KeenanMcConkey/CALVIN/README.md

# CALVIN's Website

Repository for CALVIN Engineering Physics robot project (2017).

#### Link to Website
https://keenanmcconkey.github.io/CALVIN/

*Project by Keenan McConkey, Austin Khorram, and Glyn Finck*
