KeenanMcConkey/CALVIN/index.md

Welcome to CALVIN's Website
======

### Introduction to CALVIN

CALVIN was created by Keenan McConkey, Austin Khorram, and Glyn Finck for the University of British Columbia's Engineering Physics program's annual robot competition. This year's competition involved various tasks for the robot to complete, such as line following,  infrared beacon reading, and finally picking up toys ("agents" as we called them) off platforms then putting these toys into a box, which gets to be sent down a zip-line back to the beginning of the course. CALVIN has numerous features he uses as he attempts to complete this difficult challenge and rescue the agents!

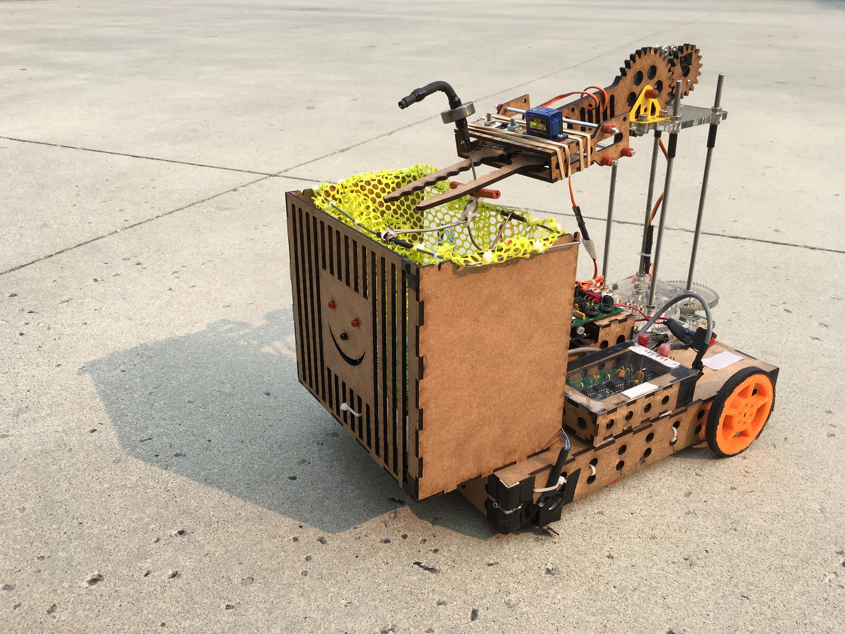
[picture p4: images/calvin_concrete.jpg]
Concrete


### CALVIN's Main Features

* Wooden Chassis
* Black Tape Detectors   
* Infrared Beacon Detectors
* Incline Detection Switches
* Modular H-Bridges and IR Signal Filters
* Servo Motor and Gear Actuated Crane, Arm, and Grabbing Claw
* TINAH Board (Arduino Board Variant)

### Navigating This Site

Check out the pages below to learn more about CALVIN's different features.

* [Mechanical](mechanical.md)
* [Electrical](electrical.md)
* [Software](software.md)

### Support or Contact

Regarding questions or inquiriues you can reach the team members at our team email address.

[CALVINteam@gmail.com](CALVINteam@gmail.com)
