KeenanMcConkey/CALVIN/electrical.md

[Return to Homepage](index.md)
# Electrical
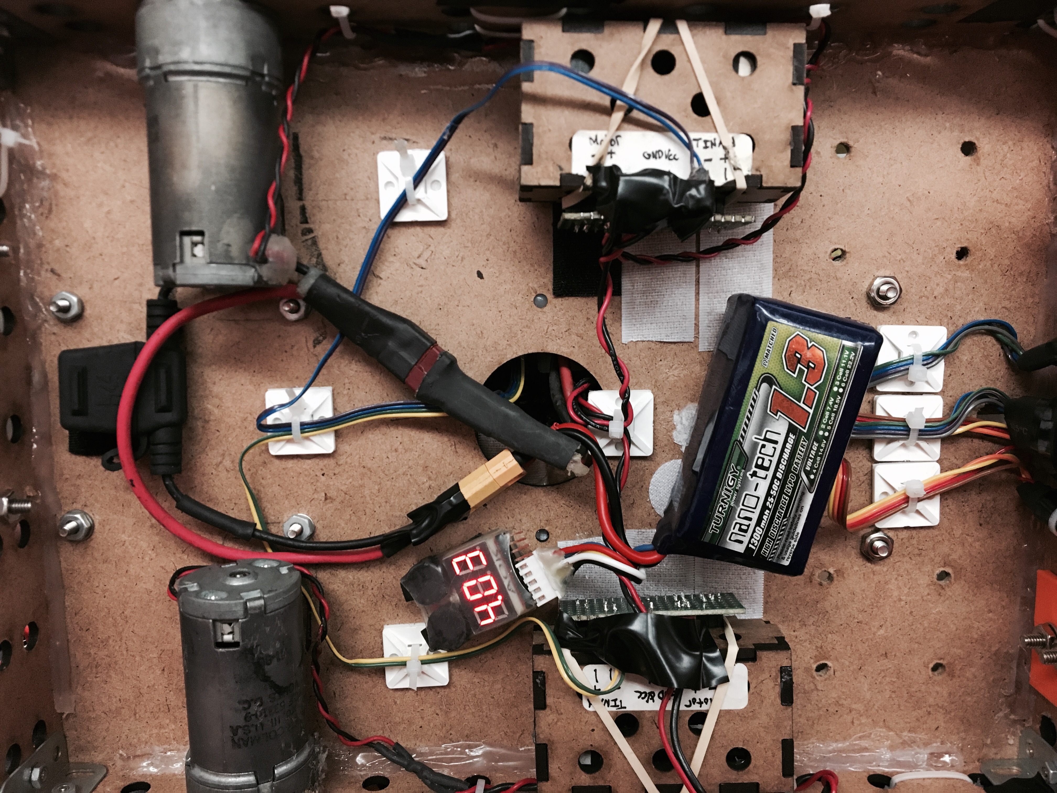
[picture p6: images/main_electrical.jpg]
Electrical Main Photo


To minimize potential troubleshooting problems we planned to simplify Calvin's electrical design as much as possible. To do this we went by a few simple rules. Number one, if we could do it in software thats what we would do. The reasoning for this was that we wanted to limit the chance of something breaking accidentally. Buy using software it would make our robot more consistent and reliable. The second rule we went by was if it works, leave it. This was because we wanted to limit the chance of something going wrong due to integrating seperate components together.

## TIHAH Microcontroller

TINAH Pinout

The microcontroller we used was a modified arduino board with inputs and other features attached to a secondary custom pcb. Features included knob's to be used for optional adjustments as well as an LCD screen. The pinout of the board used is shown above.

## H-Bridge
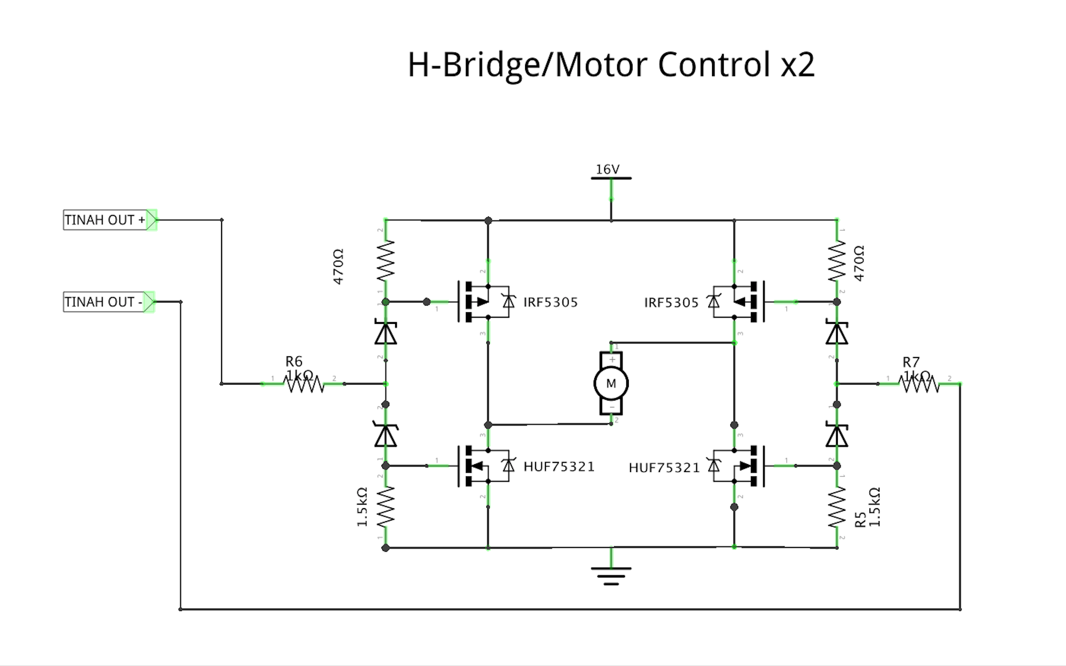
[picture p7: images/H_Bridge_Schem.png]
H-Bridge Schematic


The construction of an H-Bridge was needed to handle a high input voltage and current that would power the motors. The reason would could not do this directly from the microcontroller was because it would damage the board.

The design of the H-Bridge included the use of zener diodes and mosfets to regulate the amount of power the motors would output. A PMW (Pulse Width Modulation) voltage source was connected from the TINAH to the H-Bridge which was able to be modulated in software to set the speed our motors would run at. The average peak voltage we were able to run our motors on was around 16.5 Volts. The schematic of our H-Bridge is shown above.

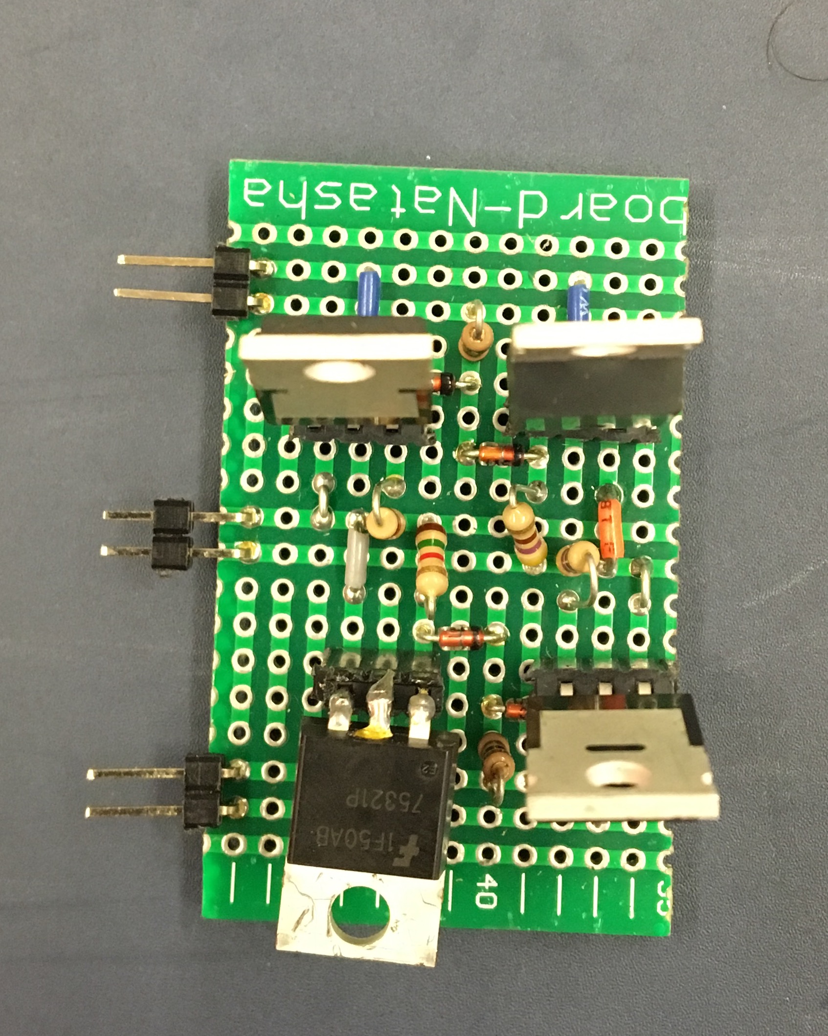
[picture p8: images/H_Bridge_Pic.jpg]
H-Bridge Picture


## IR Filter

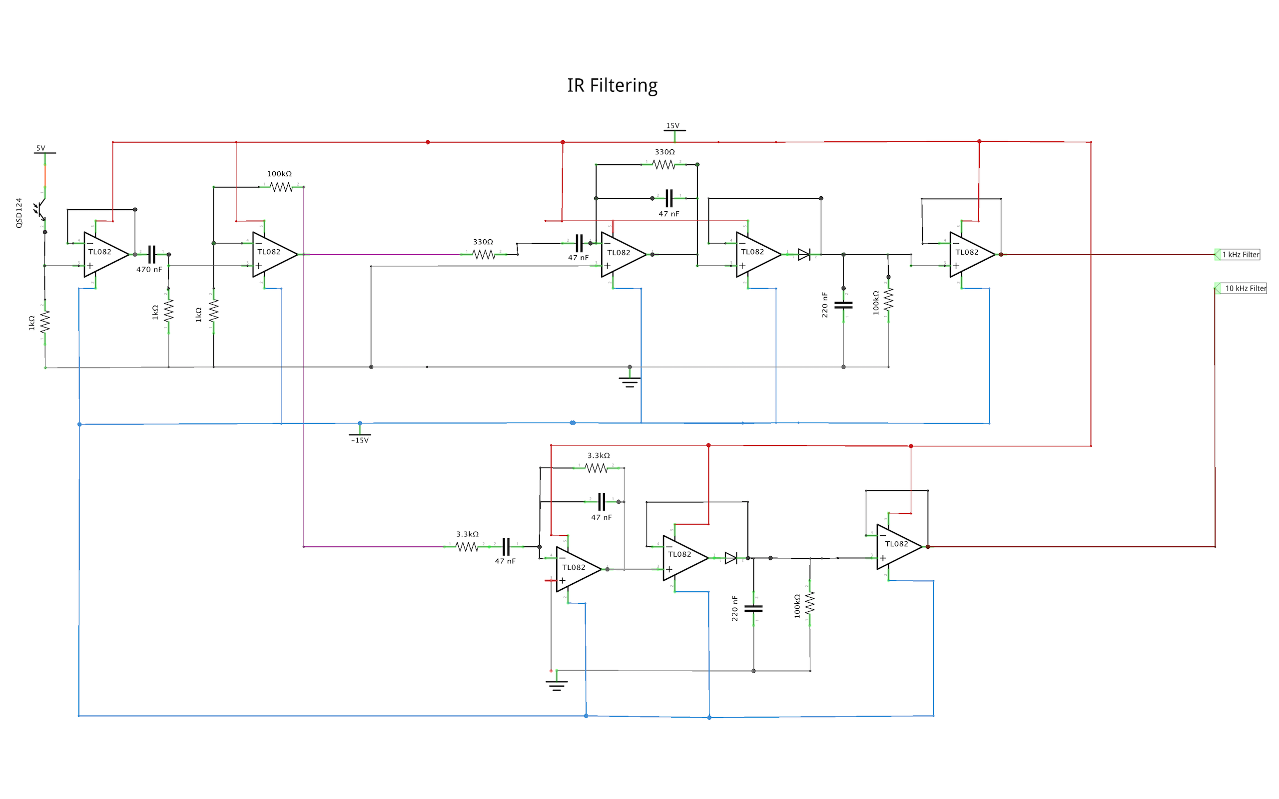
[picture p9: images/IR_Schem.png]
IR Filter Schematic


The IR filter we designed is meant to be able to tell the difference between a 10 kilo-hertz and 1 kilo-hertz infrared sine wave emitted from an IR beacon. To do this we designed our cirucit to output two signals. One of the signals would filter out frequencys lower and higher than 10 kilo-hertz and the other signal would filter out frequencys lower and higher than 1 kilo-hertz. We then connected these signals to two analog inputs on our TINAH board. In our software we programmed a function by  making an if statment where if the 10 kilo-hertz signal is a higher voltage than 1 kilo-hertz signal the function will return true. This allowed our filter to be very accurate even at larger distances as well as being accurate even if the robot was turn slightly to the right or left. It was able to do this because even if the voltages coming from the signals were to change, they would change proportionally. So if the signal coming from the beacon was 10 kilo-hertz and you turned the robot, both of the voltages would go down but the 10 kilo-hertz voltage would always be slightly larger than the 1 kilo-hertz voltage. A schematic of our IR filter is shown above.

[Return to Homepage](index.md)
