KeenanMcConkey/CALVIN/images/Photoshoot (1).jpeg

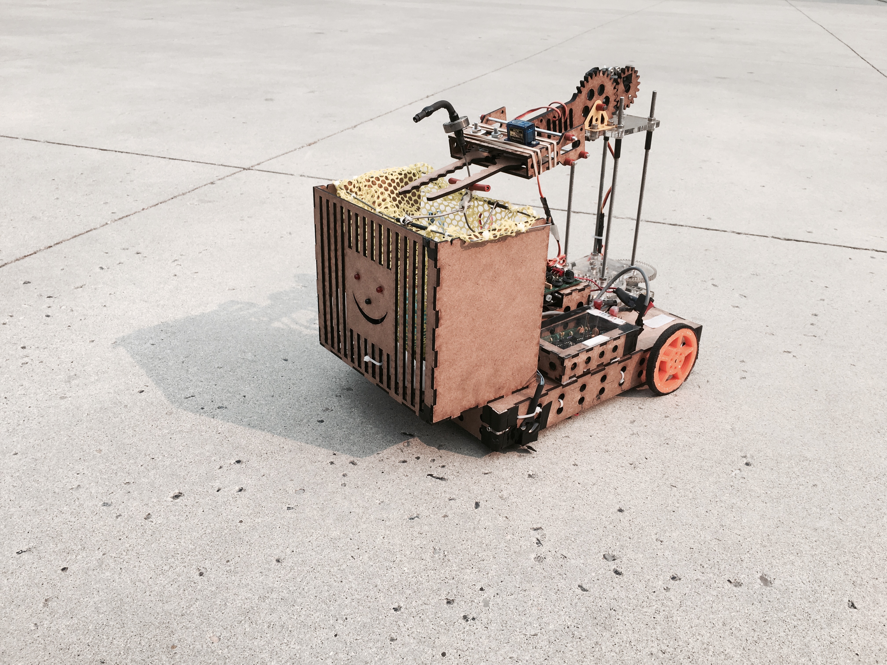
images/Photoshoot (1).jpeg
