KeenanMcConkey/CALVIN/images/Photoshoot (2).jpeg

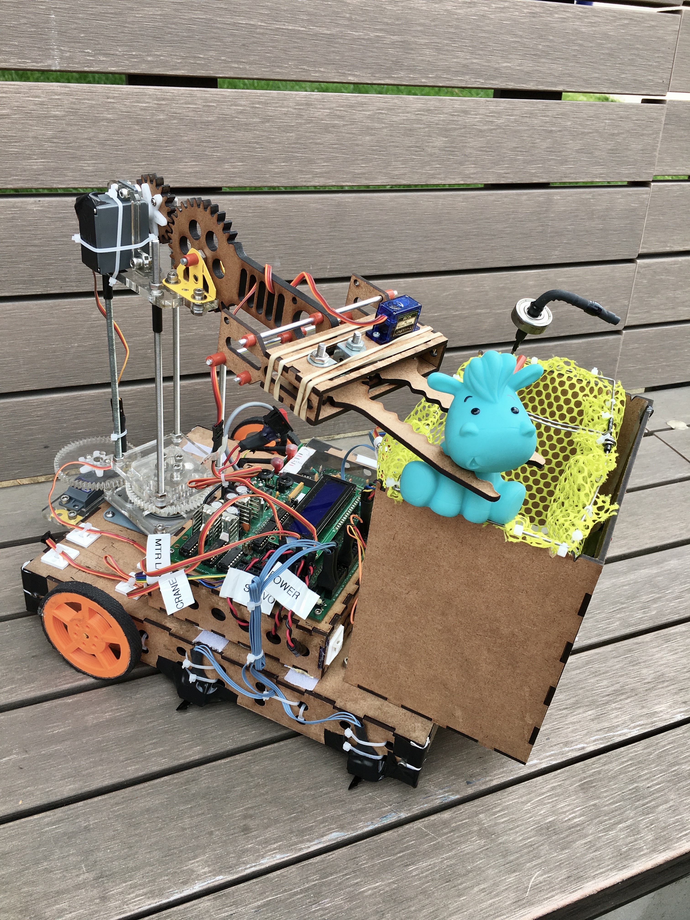
images/Photoshoot (2).jpeg
