KeenanMcConkey/CALVIN/images/Photoshoot (3).jpeg

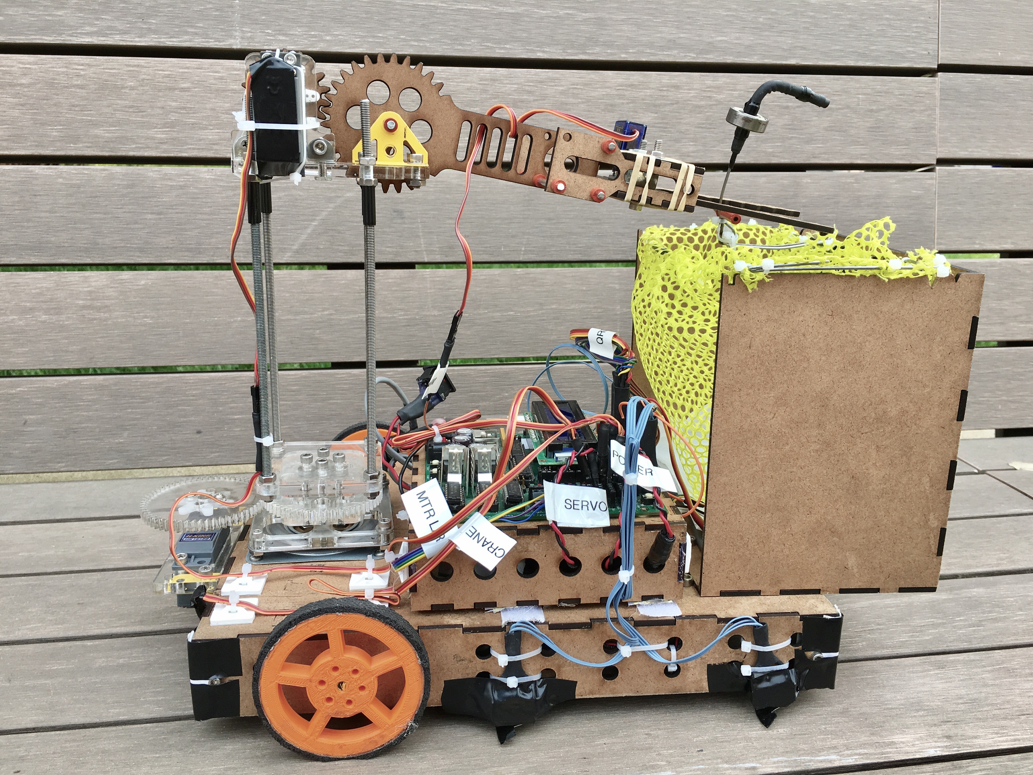
images/Photoshoot (3).jpeg
