KeenanMcConkey/CALVIN/images/Photoshoot (4).jpeg

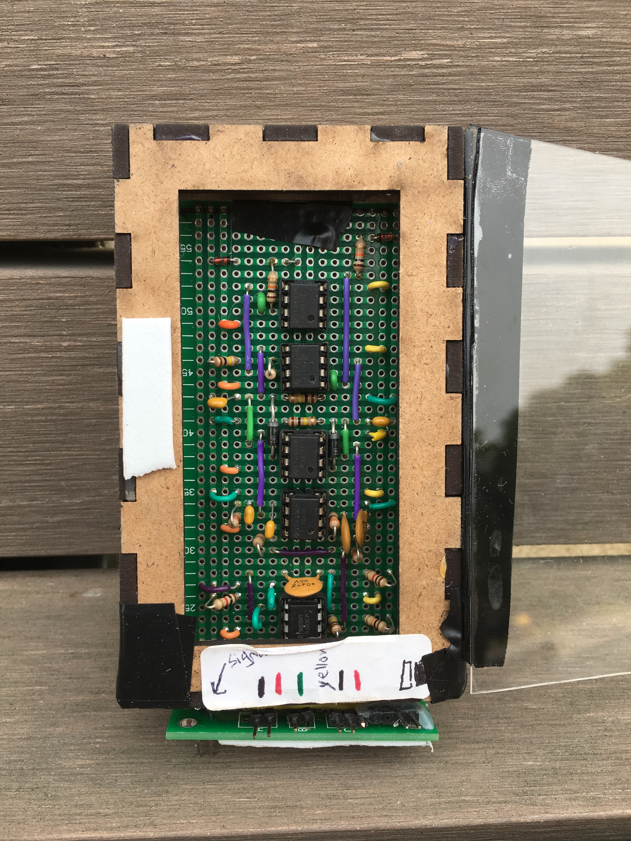
images/Photoshoot (4).jpeg
