KeenanMcConkey/CALVIN/images/Photoshoot (5).jpeg

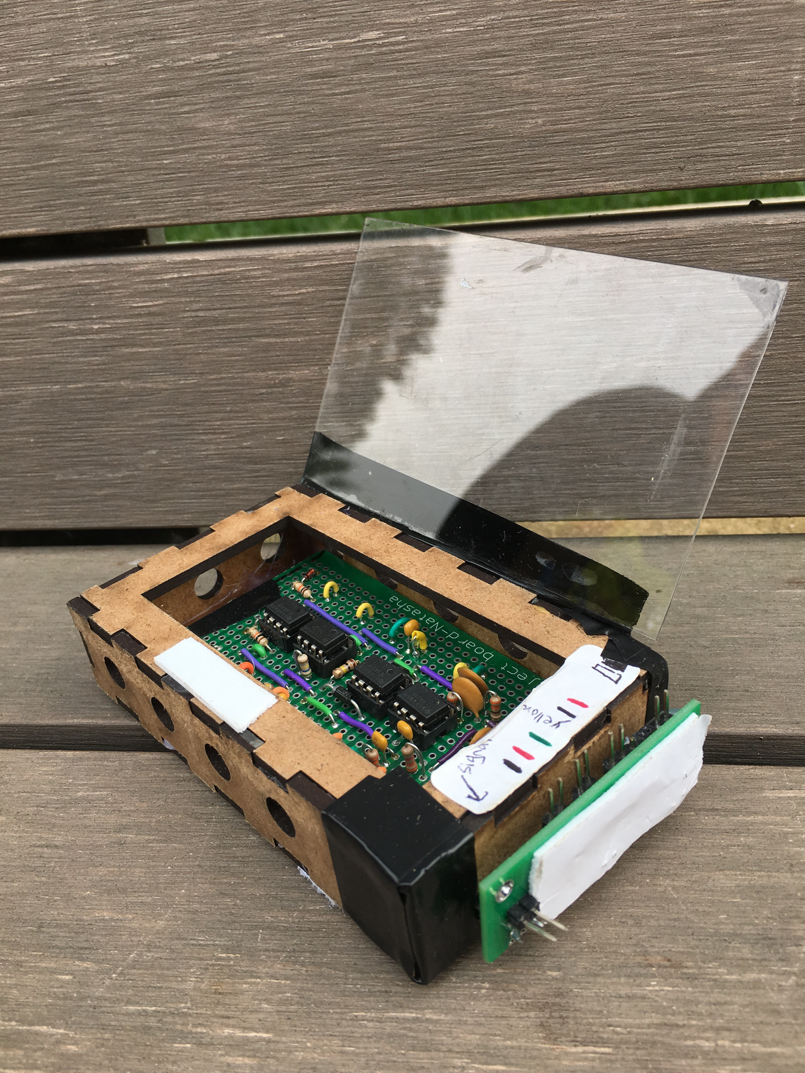
images/Photoshoot (5).jpeg
